chrisshum/capacitive-glucometer/(commit log)

2021-08-30 circuit image
2021-08-30 capacitor images
2021-08-30 paper info on cylindar capacitor
